ashaduzzaman-niloy/Calculator-from-Proteus-to-PCB-/(list of files, drawings)

Other design files:
adder sub final with pcb 2 (1).pdsprj
binary to bcd 3.pdsprj
Display.pdsprj
Divider for pcb.pdsprj
Multiplier for pcb with cap.pdsprj
MUX_Final.pdsprj
